minimal3dp/CxChanger/m3dp/klipper/README.md

# Klipper (my copies)

Copy files from `../../klipper/` here before editing. Note the upstream tag you copied from at the top of each file, so later diffs are easy:

`git diff upstream-2026-09-29 upstream-<new> -- klipper/`
