minimal3dp/CxChanger/m3dp/cad/panels-5.5-5.1-EN/README.md

# Panels for v5.5 / v5.1 — English copies

Source folder: `拼版（5.5和5.1版本）/` = "Panelized (v5.5 and v5.1)": CNC sheet-metal panels laid out for ordering (e.g. JLCCNC).
Geometry is unchanged; only names are translated (`m3dp/tools/translate_step.py`).

| Upstream file | English copy | What it is |
|---|---|---|
| 5.1摆臂PB2_螺纹可识别.step | 5.1-swing-arm-panel-PB2-modeled-threads-EN.step | Swing arm panel PB2, threads modeled so the CNC shop can detect them (4 bodies) |
| 5.1盖板PB1.step | 5.1-cover-plate-panel-PB1-EN.step | Cover plate panel PB1 (2 bodies) |
| 5.1背板2.5mm皮带槽.step | 5.1-back-plate-2.5mm-belt-slot-EN.step | Back plate with 2.5 mm belt slot |

Material tag in the files: 钢 - 缎光 = steel, satin finish.
