minimal3dp/CxChanger/m3dp/bom/README.md

# BOM

**Live BOM (source of truth):** [CxChanger_BOM_6tool Google Sheet](https://docs.google.com/spreadsheets/d/1XKfhXYksS0HXqKZEymX-_Pp8U7Hs6pY4Yzv2Vwxhv8M/edit)

`CxChanger_BOM_6tool.xlsx` is an old snapshot (2026-09-30). It predates the CAD-derived screw list,
AliExpress Choice prices, the Sirol hotend kit, the Mellow CAN cable and the AliExpress Mean Well.
Use the Google Sheet.

Fastener quantities come from `m3dp/cad/printhead-6.11-hardware.md`.
