minimal3dp/CxChanger/m3dp/cad/m3dp_cnc_6_p7.step

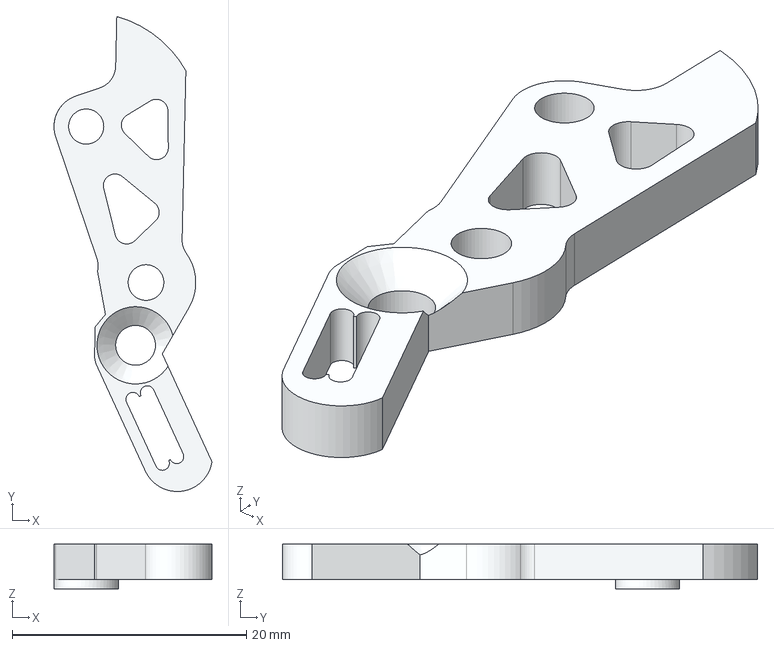
[picture p1: CAD file, 2026-10-25]
m3dp/cad/m3dp_cnc_6_p7.step
13.5 x 40.5 x 3.80 mm
