minimal3dp/CxChanger/m3dp/cad/panels-5.5-5.1-EN/5.1-back-plate-2.5mm-belt-slot-EN.step

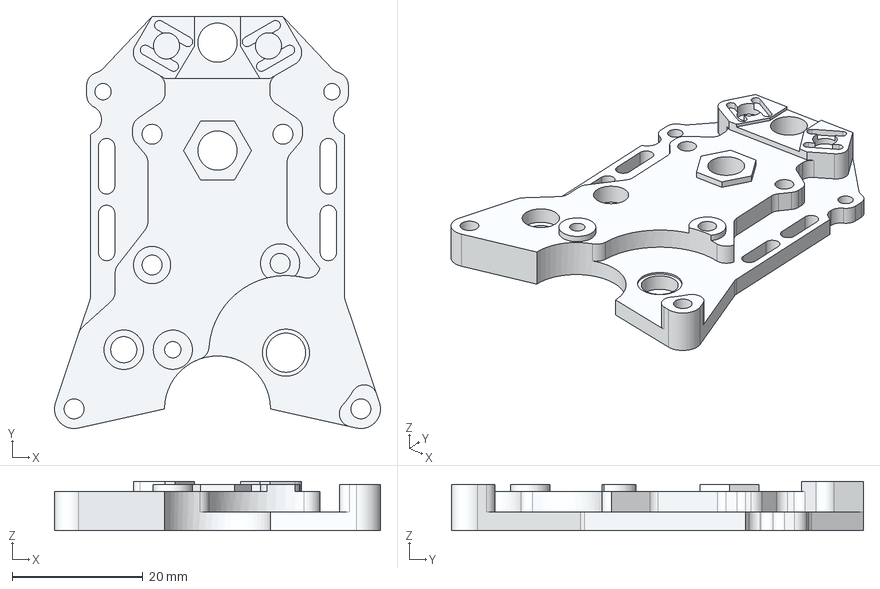
[picture p2: CAD file, 2026-10-25]
m3dp/cad/panels-5.5-5.1-EN/5.1-back-plate-2.5mm-belt-slot-EN.step
49.8 x 63.0 x 7.50 mm
