minimal3dp/CxChanger/m3dp/cad/panels-5.5-5.1-EN/5.1-swing-arm-panel-PB2-modeled-threads-EN.step

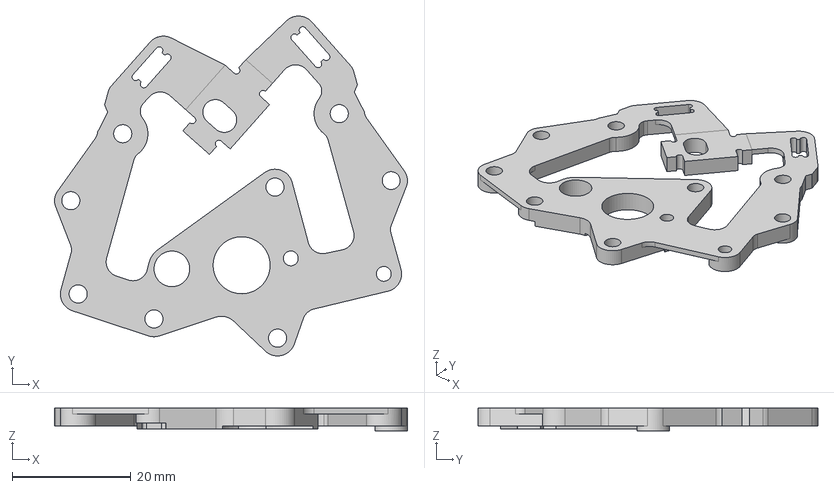
[picture p3: CAD file, 2026-10-25]
m3dp/cad/panels-5.5-5.1-EN/5.1-swing-arm-panel-PB2-modeled-threads-EN.step
59.4 x 57.2 x 3.80 mm
