minimal3dp/CxChanger/m3dp/cad/panels-5.5-5.1-EN/5.1-cover-plate-panel-PB1-EN.step

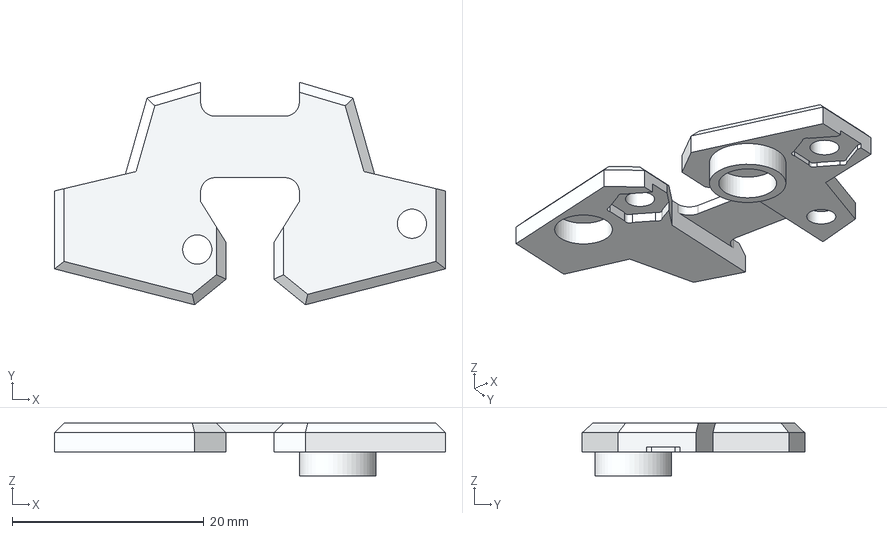
[picture p5: CAD file, 2026-10-25]
m3dp/cad/panels-5.5-5.1-EN/5.1-cover-plate-panel-PB1-EN.step
40.8 x 23.2 x 5.50 mm
