minimal3dp/CxChanger/m3dp/cad/m3dp_cnc_6_p4.step

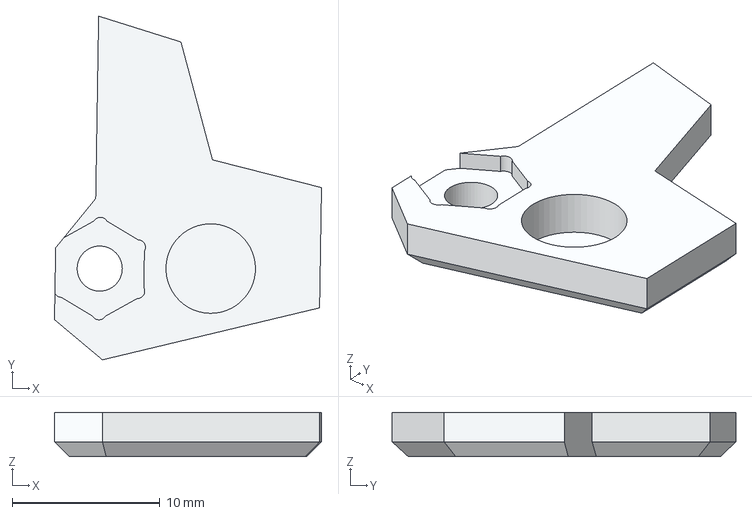
[picture p6: CAD file, 2026-10-25]
m3dp/cad/m3dp_cnc_6_p4.step
18.0 x 23.2 x 3.00 mm
