minimal3dp/CxChanger/m3dp/cad/m3dp_cnc_6_p1.step

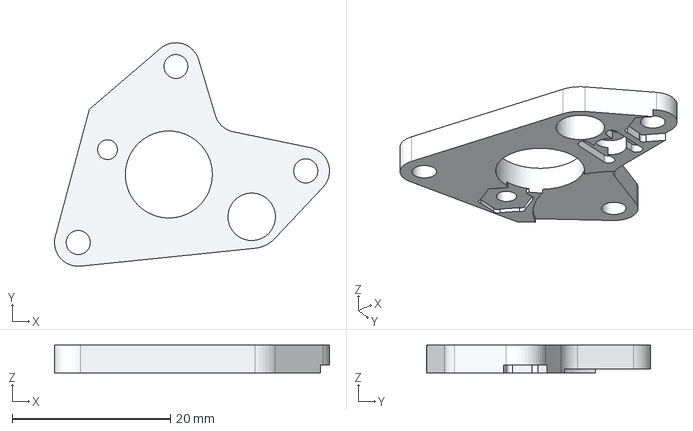
[picture p7: CAD file, 2026-10-25]
m3dp/cad/m3dp_cnc_6_p1.step
34.8 x 28.2 x 3.50 mm
