minimal3dp/CxChanger/m3dp/cad/dock-6.11-EN.STEP

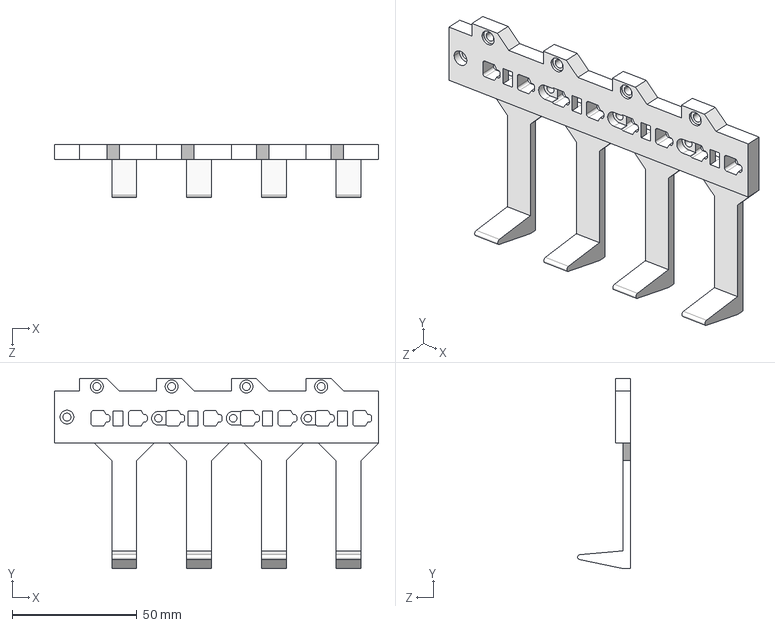
[picture p8: CAD file, 2026-10-25]
m3dp/cad/dock-6.11-EN.STEP
130.0 x 76.3 x 21.2 mm
