minimal3dp/CxChanger/m3dp/cad/m3dp_cnc_6_p6.step

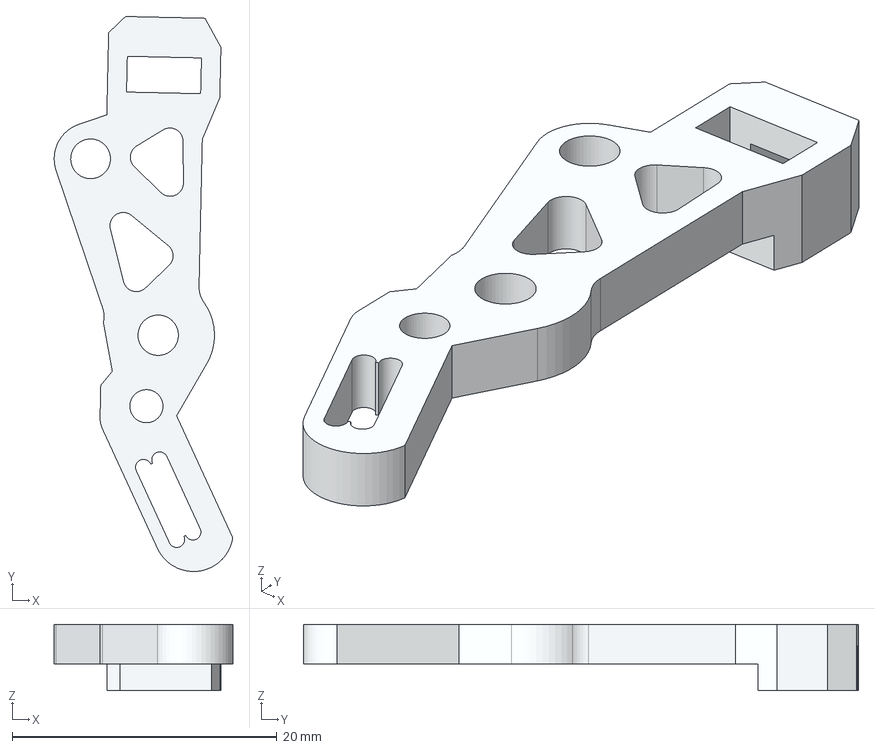
[picture p10: CAD file, 2026-10-25]
m3dp/cad/m3dp_cnc_6_p6.step
13.5 x 41.9 x 5.00 mm
