minimal3dp/CxChanger/m3dp/cad/m3dp_cnc_6_p8.step

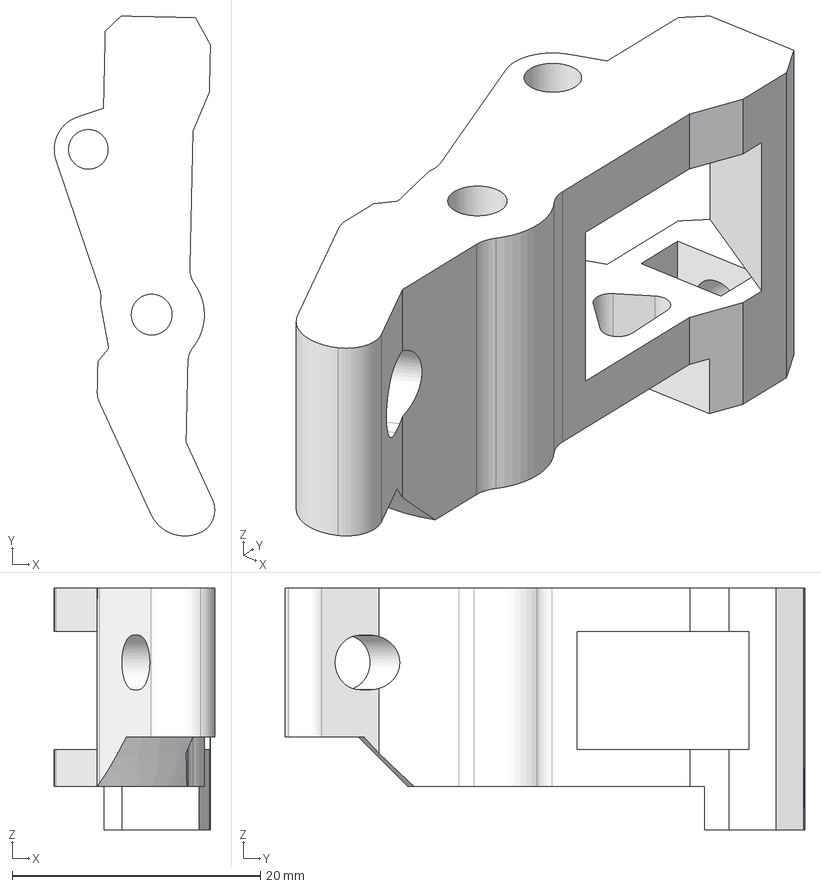
[picture p11: CAD file, 2026-10-25]
m3dp/cad/m3dp_cnc_6_p8.step
12.9 x 41.9 x 19.5 mm
