minimal3dp/CxChanger/m3dp/cad/m3dp_cnc_6_p2.step

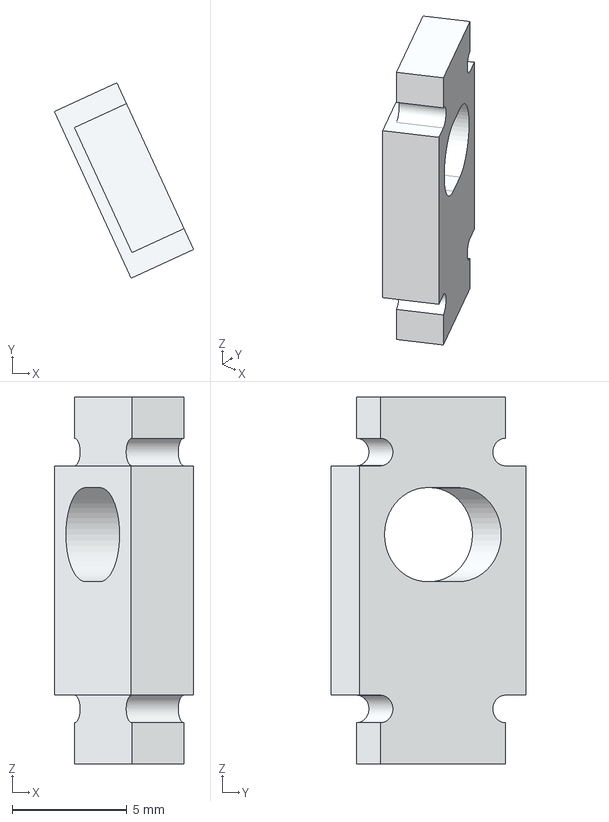
[picture p12: CAD file, 2026-10-25]
m3dp/cad/m3dp_cnc_6_p2.step
6.07 x 8.52 x 16.0 mm
