minimal3dp/CxChanger/(list of files, cad)

Other CAD files:
m3dp/cad/m3dp_cnc_6_p5.step
