minimal3dp/CxChanger/(commit log)

2026-10-01 Add 6-tool BOM (AliExpress prices checked 2026-09-30)
    Claude-Session: https://claude.ai/code/session_01PXhJBVQd7UYUJXYSS5HTog
    [CxChanger_BOM_6tool.xlsx]
2026-10-25 Updated docs
    [5.1-back-plate-2.5mm-belt-slot-EN.step, 5.1-cover-plate-panel-PB1-EN.step, 5.1-swing-arm-panel-PB2-modeled-threads-EN.step, back-plate-name-map.csv, cover-plate-PB1-name-map.csv, dock-6.11-EN.STEP, dock-6.11-name-map.csv, m3dp_cnc_6.11.step]
